ManlyMorgan/Animatronic-Eye/README.md

Instructions: https://www.instructables.com/Animatronic-Eyes-Double-and-Single-Fully-3D-Printe/
Print Files: https://makerworld.com/en/@manlymorgan
