ManlyMorgan/Animatronic-Eye/01_single/stl/Animatronic Eyes - EyeBall Ball Joint.stl

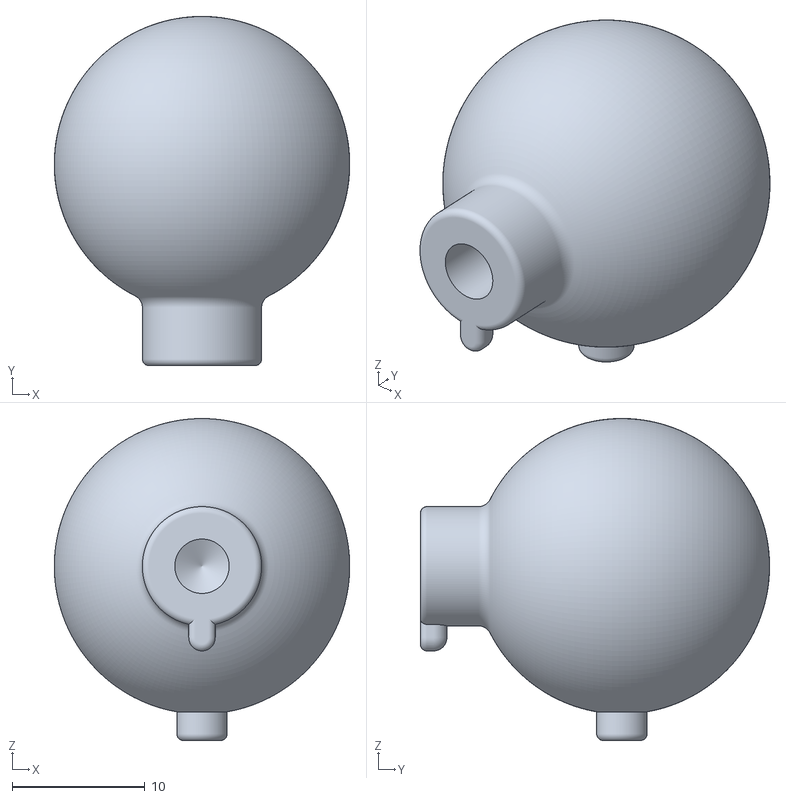
[picture p1: CAD file, 2025-03-16]
01_single/stl/Animatronic Eyes - EyeBall Ball Joint.stl
22.3 x 26.4 x 24.3
