ManlyMorgan/Animatronic-Eye/02_double/stl/Animatronic Eyes - Eyelid_Upper_L.stl

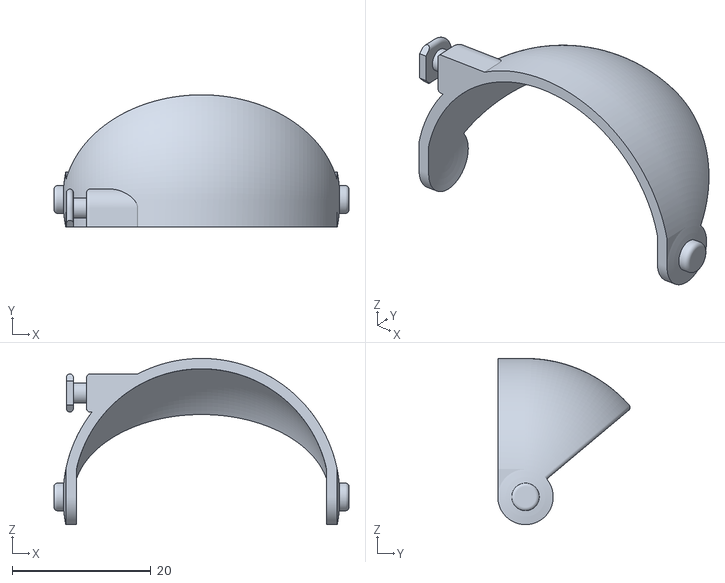
[picture p2: CAD file, 2025-03-16]
02_double/stl/Animatronic Eyes - Eyelid_Upper_L.stl
42.6 x 19.1 x 24.0
