ManlyMorgan/Animatronic-Eye/02_double/stl/Animatronic Eyes - Linkage_Upper_L.stl

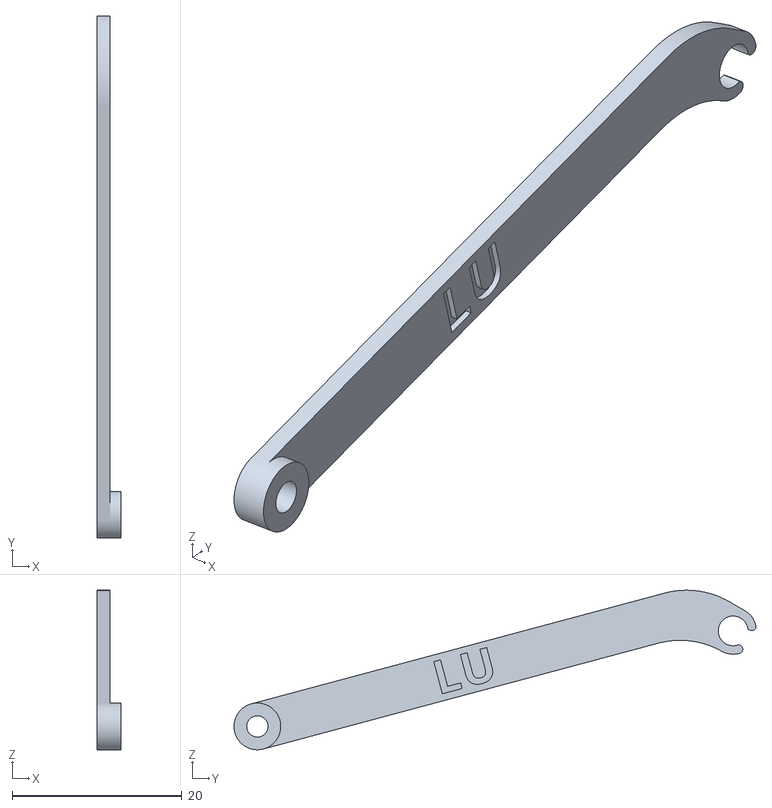
[picture p3: CAD file, 2025-03-16]
02_double/stl/Animatronic Eyes - Linkage_Upper_L.stl
2.80 x 61.4 x 18.8
