ManlyMorgan/Animatronic-Eye/01_single/stl/Animatronic Eyes - Linkage_Lower_L.stl

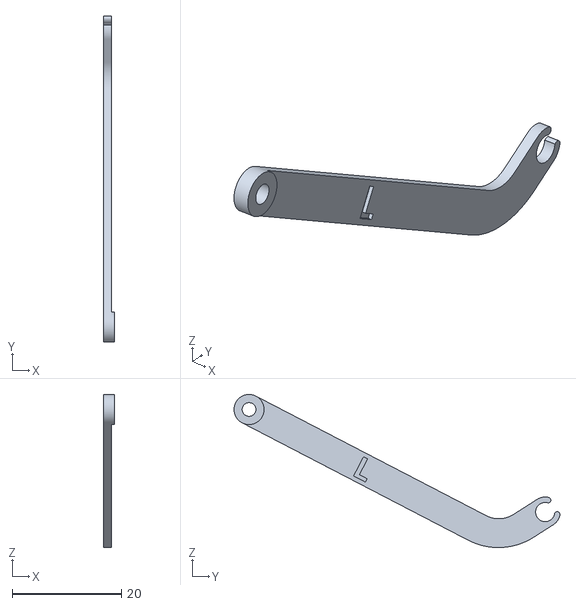
[picture p4: CAD file, 2025-03-16]
01_single/stl/Animatronic Eyes - Linkage_Lower_L.stl
2.04 x 59.6 x 28.0
