ManlyMorgan/Animatronic-Eye/02_double/stl/Animatronic Eyes - Linkage_Lower_R.stl

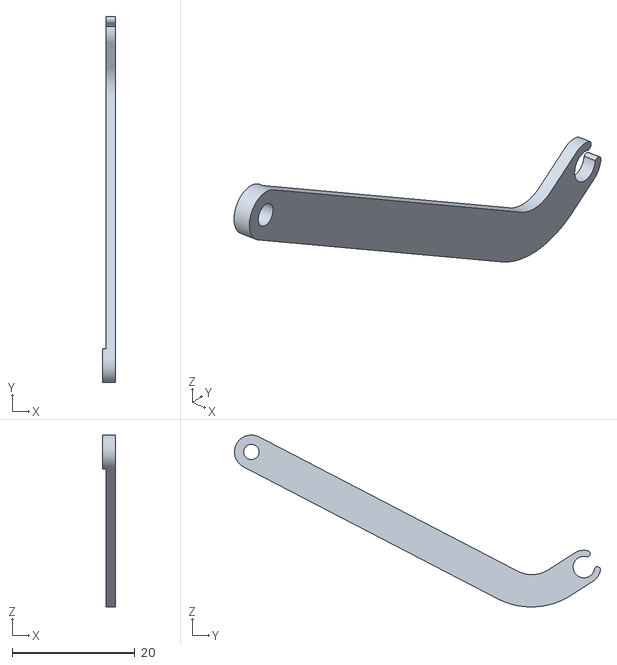
[picture p5: CAD file, 2025-03-16]
02_double/stl/Animatronic Eyes - Linkage_Lower_R.stl
2.04 x 59.6 x 28.0
