ManlyMorgan/Animatronic-Eye/01_single/stl/Animatronic Eyes - Linkage_Upper_L.stl

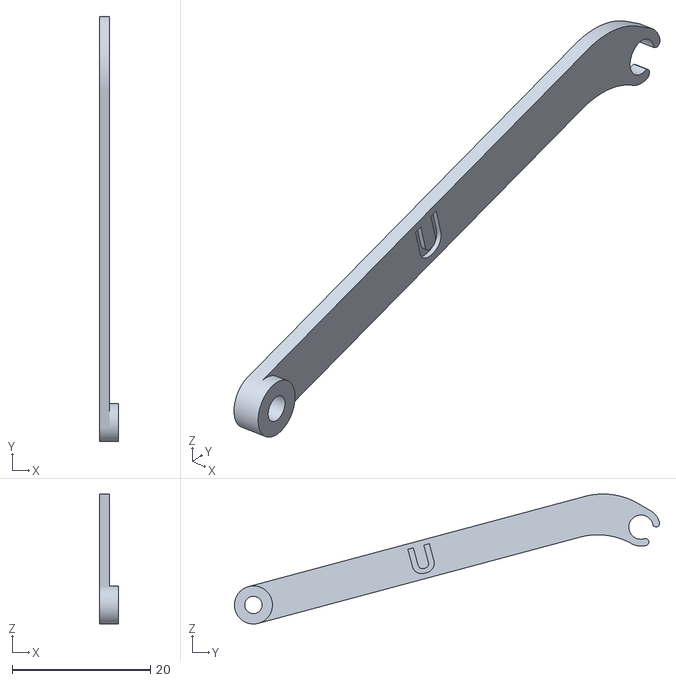
[picture p6: CAD file, 2025-03-16]
01_single/stl/Animatronic Eyes - Linkage_Upper_L.stl
2.80 x 61.4 x 18.8
