ManlyMorgan/Animatronic-Eye/(list of files, cad)

Other CAD files:
02_double/stl/Animatronic Eyes - Eyelid_Upper_R.stl
02_double/stl/Animatronic Eyes - Linkage_Upper_R.stl
02_double/stl/Animatronic Eyes - Linkage_Lower_L.stl
