ManlyMorgan/Animatronic-Eye/(list of files, drawings)

Other design files:
05_instruction/Single_Eye.fzz
