ManlyMorgan/Animatronic-Eye/05_instruction/Single_Eye.png

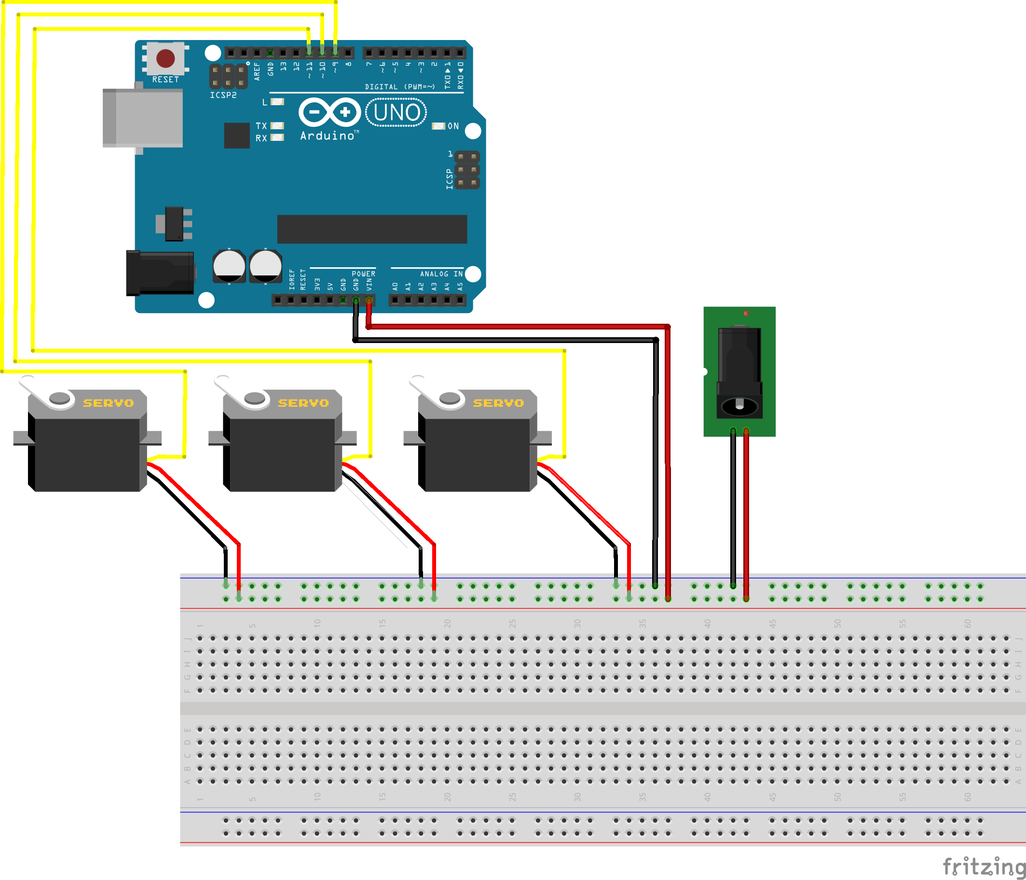
05_instruction/Single_Eye.png
