ManlyMorgan/Animatronic-Eye/04_characterisation/Angles.xlsx

Left Right
Eye Angle | Servo Angle
0.177 | 0
4.966 | 5
9.794 | 10
14.491 | 15
19.052 | 20
23.469 | 25
27.726 | 30
31.762 | 35
35.621 | 40
-5.149 | -5
-10.433 | -10
-15.932 | -15
-22.561 | -20
-28.79 | -25
8 | -30
Up Down
Eye Angle | Servo Angle
0.2367 | 0
4.317406 | 5
8.35847 | 10
12.410435 | 15
16.395069 | 20
20.327501 | 25
24.168799 | 30
27.913385 | 35
31.462178 | 40
34.707502 | 45
37.691145 | 50
40.291204 | 55
-3.835597 | -5
-7.9492 | -10
-12.060695 | -15
-16.206694 | -20
-20.389556 | -25
-24.622672 | -30
-28.934893 | -35
-33.328381 | -40
-37.968103 | -45
