ManlyMorgan/Animatronic-Eye/(commit log)

2025-03-17 calibration folder
    [Angles.xlsx, Single_Eye.fzz]
2025-03-17 added instructions
    [Single_Eye.fzz]
